ollenorelius/doorOpener/README.md

## doorOpener

This is the PCB for my BLE door opener, based on a nRF52831 microcontroller

### Version 1.1
- Fixed 3v3 not being connected to micro
- Fixed HV high side switch mosfet being the wrong way around (damn body diode!)
- Fixed error in footprint of AP1609
