ollenorelius/doorOpener/door/door_board.brd

## EAGLE design door/door_board.brd (2020-03-29)

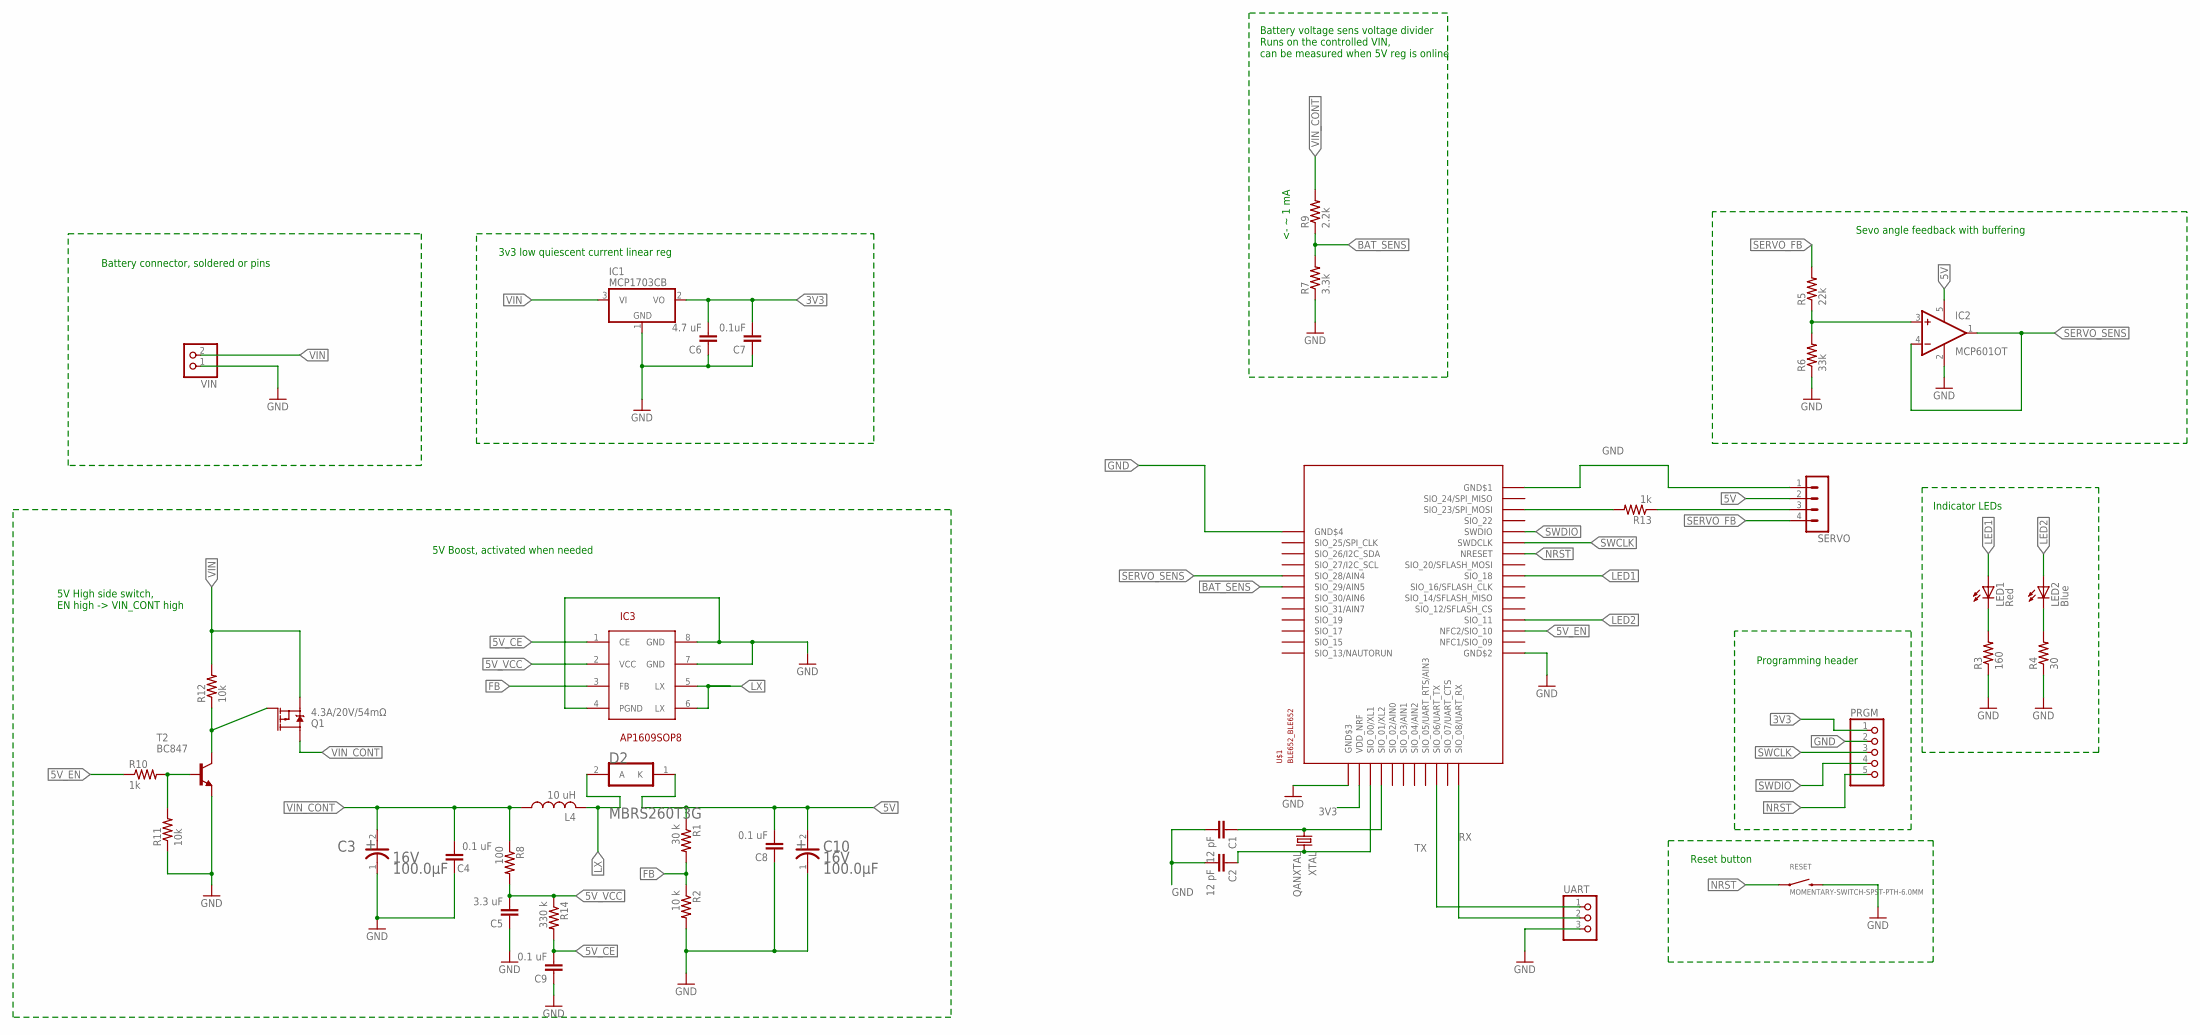
[picture p1: schematic door_board.sch]

Parts:
C1, C2: 12 pF; C0603
C3, C10: PANASONIC_EEE-FK1C101PPANASONIC_EEE-FK1C101P_0_0; PANASONIC_EEE-FK1C101P_0
C4, C8, C9: 0.1 uF; C0805
C5: 3.3 uF; C0805
C6: 4.7 uF; C0805
C7: 0.1uF; C0805
D2: ON_SEMICONDUCTOR_MBRS260T3GON_SEMICONDUCTOR_MBRS2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; ON_SEMICONDUCTOR_MBRS260T3G_0
IC1: MCP1703CB; SOT23
IC2: MCP601OT; SOT23-5
IC3: AP1609SOP8; SOIC127P600X175-8
L4: 10 uH; SMT
LED1: Red; CHIP-LED0805
LED2: Blue; CHIP-LED0805
PRGM: PINHD-1X5; 1X05
Q1: 4.3A/20V/54mΩ; SOT23-3
R1: 30 k; M0805
R2: 10 k; M0805
R3: 160; M0805
R4: 30; M0805
R5: 22k; M0805
R6: 33k; M0805
R7: 3.3k; M0805
R8: 100; M0805
R9: 2.2k; M0805
R10, R13: 1k; M0805
R11, R12: 10k; M0805
R14: 330 k; M0805
RESET: MOMENTARY-SWITCH-SPST-PTH-6.0MM; TACTILE_SWITCH_PTH_6.0MM
SERVO: MA04-1
T2: BC847; SOT23
U$1: BLE652_BLE652; BLE652_BL652
UART: PINHD-1X3; 1X03
VIN: PINHD-1X2; 1X02
XTAL: QANXTAL; QANTEKXTAL

Connections:
3V3: C6.2, C7.2, IC1.2 (VO), PRGM.1, U$1.P$26 (VDD_NRF)
5V: C8.2, C10.2 (ANODE), D2.1 (K), IC2.5 (V+), R1.1, SERVO.2
5V_CE: C9.2, IC3.1 (CE), R14.2
5V_EN: R10.1, U$1.P$14 (NFC2/SIO_10)
5V_VCC: C5.2, IC3.2 (VCC), R8.2, R14.1
ADFSGSDFH: IC2.3 (+IN), R5.1, R6.2
BAT_SENS: R7.2, R9.1, U$1.P$34 (SIO_29/AIN5)
FB: IC3.3 (FB), R1.2, R2.1
GND: C1.2, C2.2, C3.1 (CATHODE), C4.1, C5.1, C6.1, C7.1, C8.1, C9.1, C10.1 (CATHODE), IC1.1 (GND), IC2.2 (V-), IC3.4 (PGND), IC3.7 (GND), IC3.8 (GND), PRGM.2, R2.2, R3.1, R4.1, R6.1, R7.1, R11.1, RESET.3 (2), SERVO.1, T2.2 (E), U$1.P$1 (GND$1), U$1.P$16 (GND$2), U$1.P$27 (GND$3), U$1.P$39 (GND$4), UART.3, VIN.1
LED1: LED1.A, U$1.P$9 (SIO_18)
LED2: LED2.A, U$1.P$13 (SIO_11)
LX: D2.2 (A), IC3.5 (LX), IC3.6 (LX), L4.P2 (2)
unnamed: C1.1, U$1.P$24 (SIO_01/XL2), XTAL.1
unnamed: C2.1, U$1.P$25 (SIO_00/XL1), XTAL.2
unnamed: R13.1, SERVO.3
unnamed: LED2.C, R4.2
unnamed: LED1.C, R3.2
unnamed: R10.2, R11.2, T2.1 (B)
unnamed: Q1.1 (G), R12.1, T2.3 (C)
unnamed: R13.2, U$1.P$3 (SIO_23/SPI_MOSI)
NRST: PRGM.5, RESET.1, U$1.P$7 (NRESET)
RX: U$1.P$17 (SIO_08/UART_RX), UART.2
SERVO_FB: R5.2, SERVO.4
SERVO_SENS: IC2.1 (OUT), IC2.4 (-IN), U$1.P$35 (SIO_28/AIN4)
SWCLK: PRGM.3, U$1.P$6 (SWDCLK)
SWDIO: PRGM.4, U$1.P$5 (SWDIO)
TX: U$1.P$19 (SIO_06/UART_TX), UART.1
VIN: IC1.3 (VI), Q1.2 (S), R12.2, VIN.2
VIN_CONT: C3.2 (ANODE), C4.2, L4.P1 (1), Q1.3 (D), R8.1, R9.2

Notes on the sheet:
<- ~ 1 mA
Battery voltage sens voltage divider Runs on the controlled VIN, can be measured when 5V reg is online
Sevo angle feedback with buffering
Indicator LEDs
Programming header
5V Boost, activated when needed
3v3 low quiescent current linear reg
Reset button
Battery connector, soldered or pins
5V High side switch, EN high -> VIN_CONT high

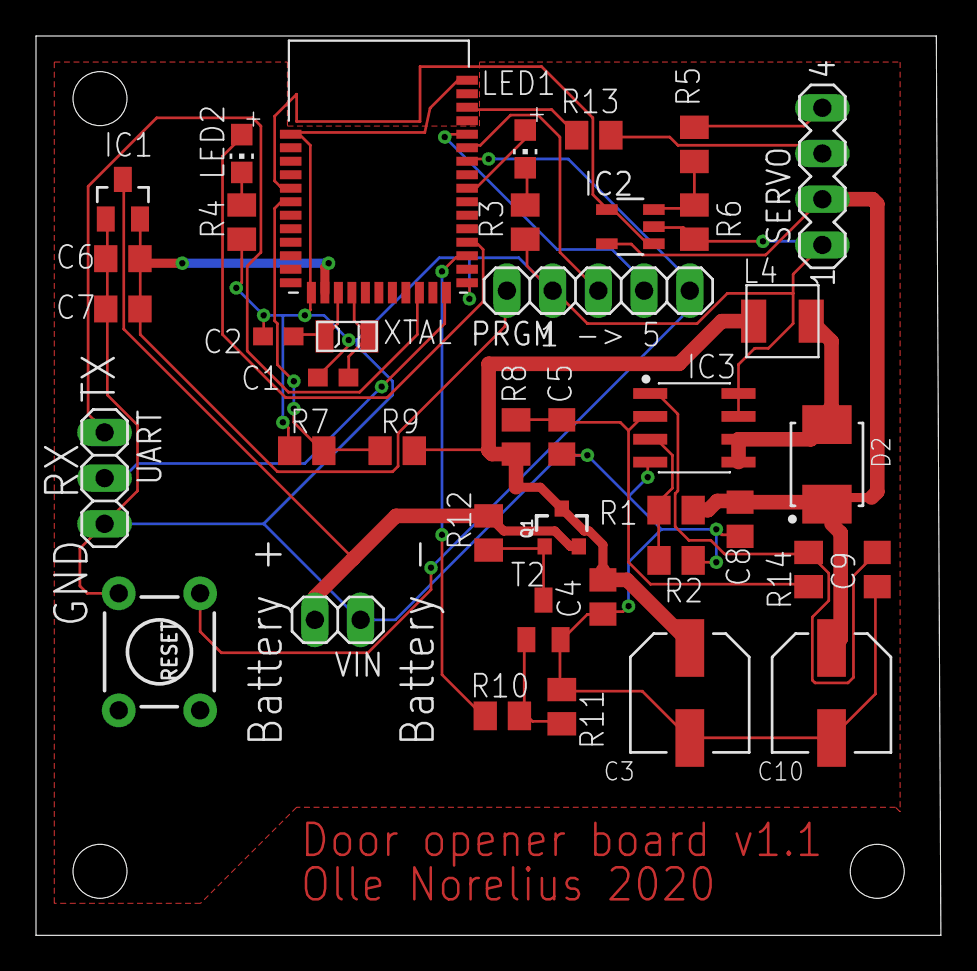
[picture p2: board door_board.brd from above]

Board: 2 copper layers, 50.3 x 50.0 mm, 40 parts (0 on the bottom side), 29 nets.
