ollenorelius/doorOpener/(commit log)

2019-03-28 initial PCB commit
    [door_board.brd, door_board.sch]
2020-03-29 Updated board to version 1.1
    Fixed VCC to nrf
    Flipped HV enable high side mosfet
    Corrected AP1609 footprint
    Updated board text
    [door_board.brd, door_board.sch]
2020-03-29 Version text updated
    Forgot this in last commit
    [door_board.brd]
